CCMNR/board/rcj_res_b_board.kicad_pcb

## KiCad design rcj_res_b_board.kicad_pcb (2017-06-26)

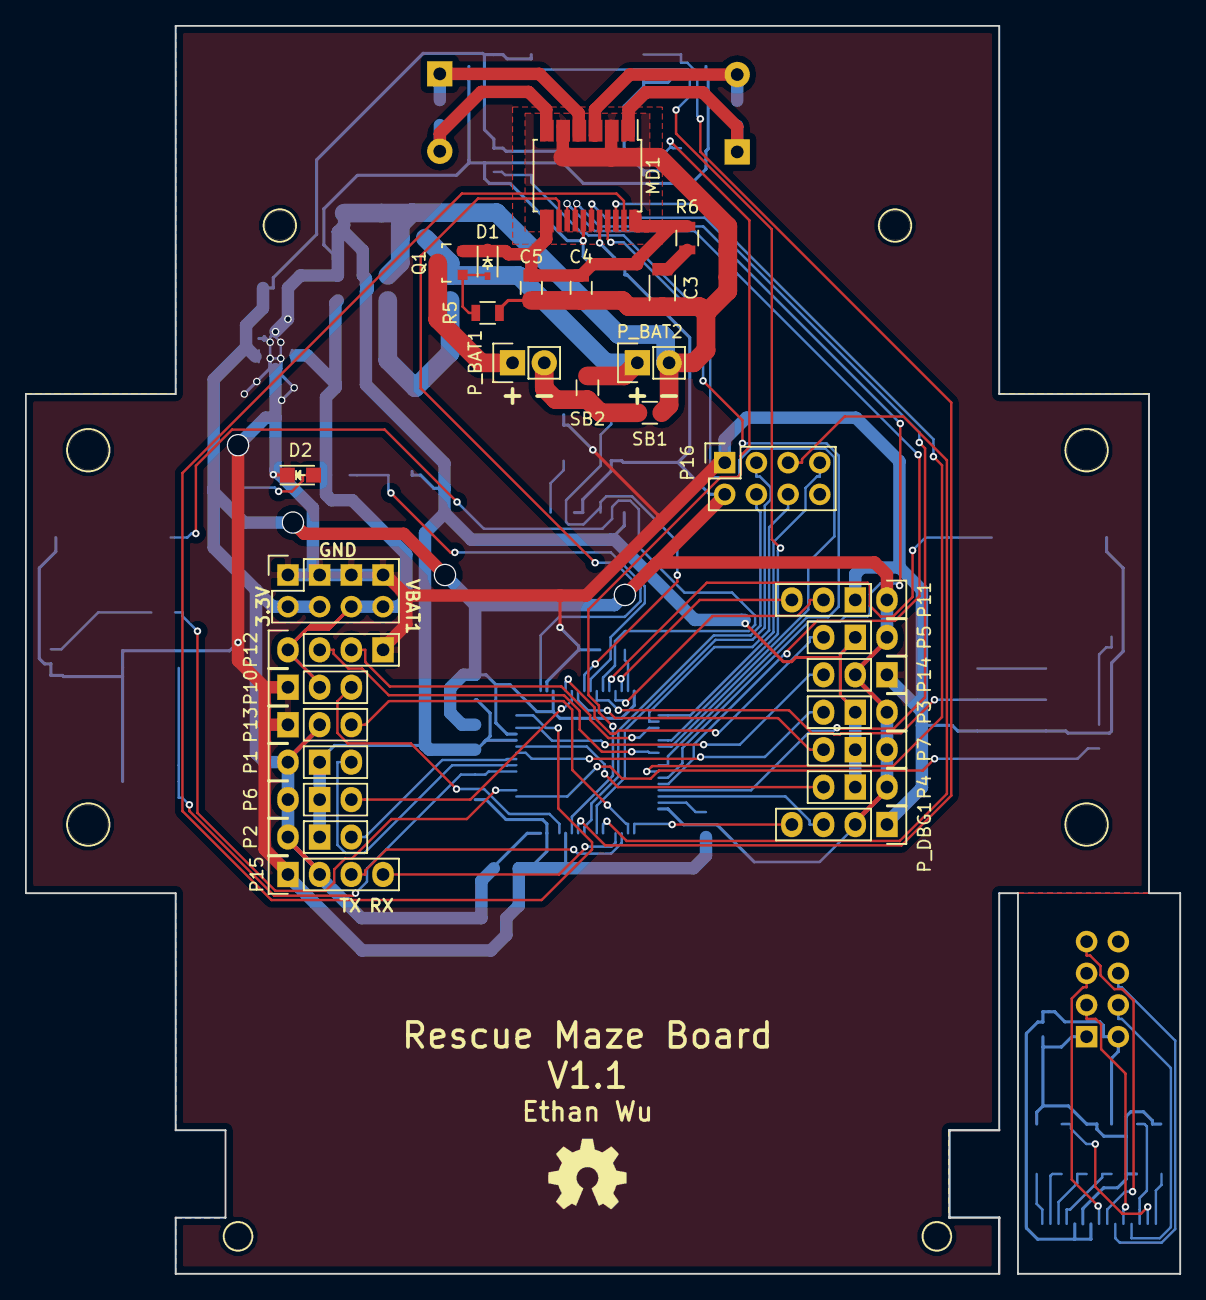
[picture p1: board rcj_res_b_board.kicad_pcb from above]

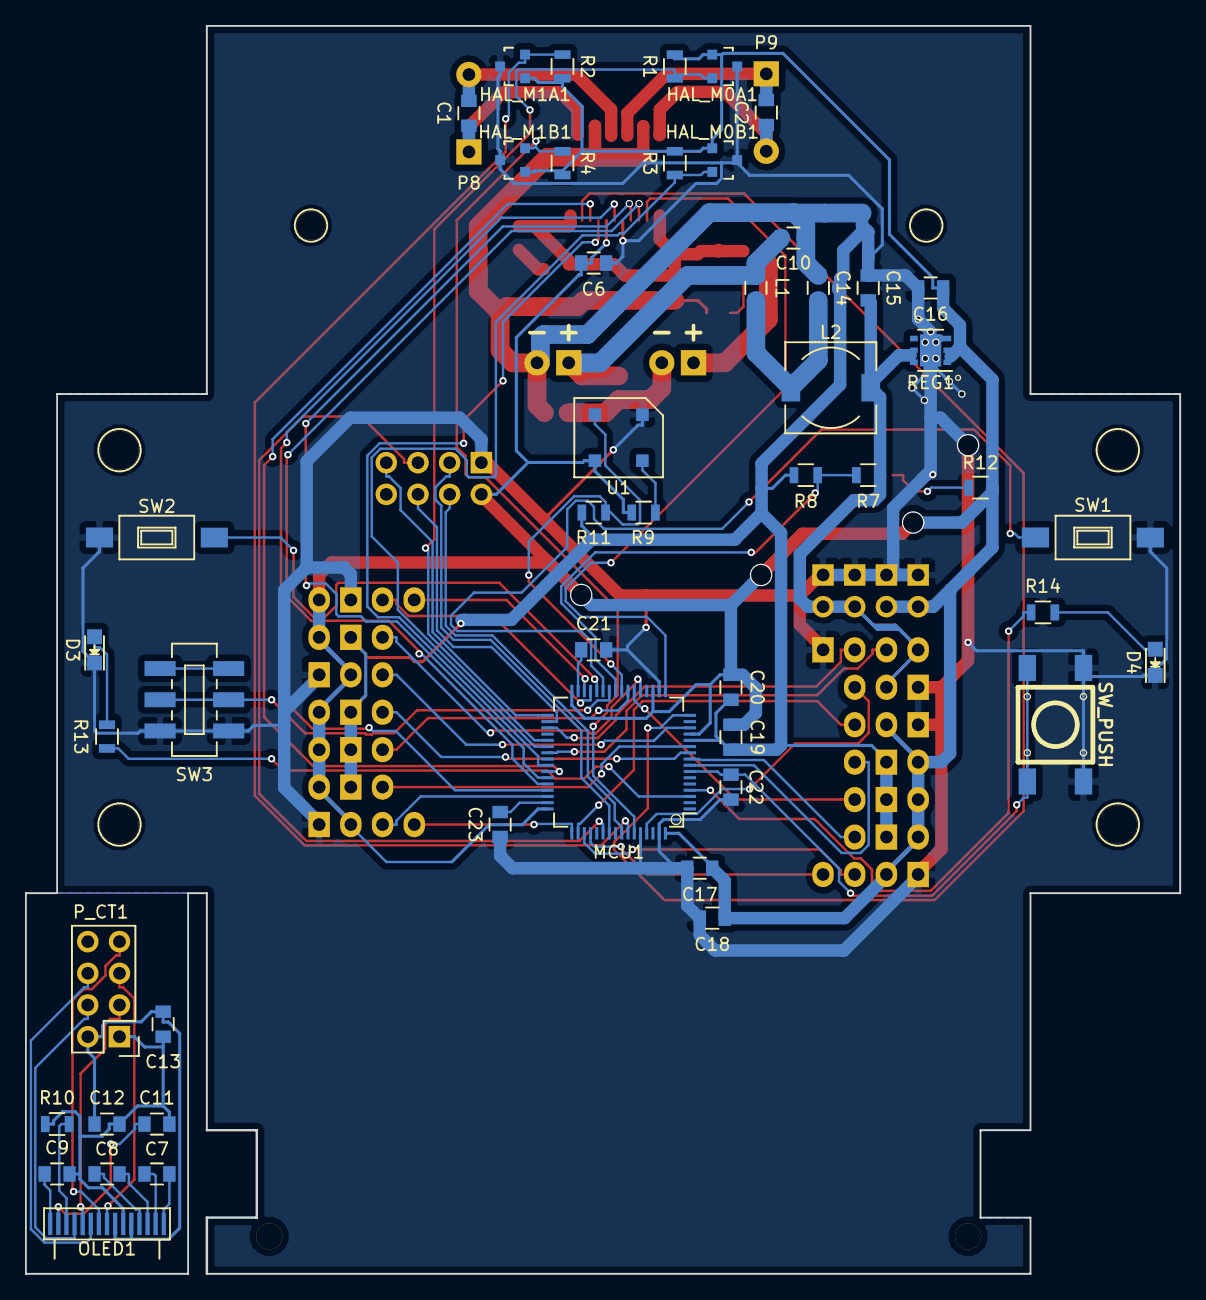
[picture p2: board rcj_res_b_board.kicad_pcb from below]

Board: 2 copper layers, 92.5 x 100.0 mm, 93 parts (54 on the bottom side), 80 nets.

Parts:
C1, C2: 3.3nF; C_0805
C3: 10uF; C_1206
C4, C6, C10, C18, C20: 0.1uF; C_0805
C5: 0.47uF; C_0805
C7, C8, C12, C13, C14: 1uF; C_0805
C9, C11, C15, C16, C17, C19, C21, C23: 10uF; C_0805
C22: 0.01uF; C_0805
D1: 6.8V; SOD-323
D2, D3, D4: LED; LED-0805
G001: LOGO; OSH_LOGO
HAL_M0A1, HAL_M0B1, HAL_M1A1, HAL_M1B1: AH1751; SOT-23
HOLE1, HOLE2, HOLE3, HOLE4, HOLE5, HOLE6, HOLE7, HOLE8: 1pin
L1: L_Small; C_0805
L2: L_Small; Choke_SMD_7.3x7.3_H3.5
MCU1: STM32F405RG; LQFP-64_10x10mm_Pitch0.5mm
MD1: TB6612FNG; SSOP-24_5.3x8.2mm_Pitch0.65mm
NT1, NT2: Net_Tie; NET_TIE_1.5mm
NT3, NT4: Net_Tie; NET_TIE_1mm
OLED1: UG-2832HSWEG04
P1, P2, P3, P4: GP2Y0A41SK0F; Socket_Strip_Straight_1x03
P5, P6, P7: GP2Y0A21YK; Socket_Strip_Straight_1x03
P8, P9: CONN_01X02; Socket_Strip_Straight_1x02
P10: SERVO0; Socket_Strip_Straight_1x03
P11: MPU9250; Socket_Strip_Straight_1x04
P12: PING0; Socket_Strip_Straight_1x04
P13, P14: CONN_01X03; Socket_Strip_Straight_1x03
P15: CONN_01X04; Socket_Strip_Straight_1x04
P16: CONN_02X04; Socket_Strip_Straight_2x04
P_BAT1, P_BAT2: CONN_01X02; Pin_Header_Straight_1x02
P_CT1: CONN_02X04; Pin_Header_Straight_2x04
P_DBG1: CONN_01X04; Socket_Strip_Straight_1x04
P_PWR1: CONN_02X04; Socket_Strip_Straight_2x04
Q1: Q_PMOS_GSD; SOT-23
R1, R2, R3, R4, R7, R8, R11: 10k; R_0805
R5: 100k; R_0805
R6: 1; R_0805
R9: 100; R_0805
R10: 390k; R_0805
R12, R13, R14: 1k; R_0805
REG1: LD39200PU; DFN-6-1EP_3x3mm_Pitch0.95mm
SB1, SB2: 0; R_0805
SW1, SW2: SW_PUSH; SW_SPST_FSMSM
SW3: SWITCH_INV; JS202011SCQN
SW_RST1: SW_PUSH; Switch_FSM_JSM
U1: OPB733TR

Connections:
/3.3V: C6.2, C16.1, C17.1, C18.1, C19.1, C20.1, HAL_M0A1.1, HAL_M0B1.1, HAL_M1A1.1, HAL_M1B1.1, MCU1.13, MCU1.19, MCU1.32, MCU1.48, MCU1.64, MD1.20, P1.1, P2.1, P3.1, P4.1, P5.1, P6.1, P7.1, P11.1, P13.2, P14.2, P15.2, P16.2, P_DBG1.2, P_PWR1.2, P_PWR1.4, R1.1, R2.1, R3.1, R4.1, R9.1, R12.1, REG1.1, REG1.2, U1.3
/I2C_SCL: MCU1.29, P11.3
/I2C_SDA: MCU1.30, P11.4
/IR_L_F: MCU1.21, P5.3
/IR_L_L: MCU1.22, P6.3
/IR_L_R: MCU1.23, P7.3
/IR_S_LB: MCU1.9, P2.3
/IR_S_LF: MCU1.8, P1.3
/IR_S_RB: MCU1.11, P4.3
/IR_S_RF: MCU1.10, P3.3
/LED_USR1: MCU1.3, R13.1
/LED_USR2: MCU1.4, R14.1
/LS_FLOOR: MCU1.24, R11.1, U1.2
/M0_ENC_A: HAL_M0A1.2, MCU1.37, R1.2
/M0_ENC_B: HAL_M0B1.2, MCU1.38, R3.2
/M1_ENC_A: HAL_M1A1.2, MCU1.58, R2.2
/M1_ENC_B: HAL_M1B1.2, MCU1.59, R4.2
/MD_AIN1: MCU1.41, MD1.21
/MD_AIN2: MCU1.42, MD1.22
/MD_APWM: MCU1.16, MD1.23
/MD_BIN1: MCU1.43, MD1.17
/MD_BIN2: MCU1.44, MD1.16
/MD_BPWM: MCU1.17, MD1.15
/MD_STBY: MCU1.45, MD1.19
/MODE_SEL: MCU1.26, SW3.2
/MOSI: MCU1.57, P16.4
/OLED_Circuitry/3.3V: C12.1, C13.1, OLED1.5, OLED1.7, P_CT1.2
/OLED_Circuitry/D-C: OLED1.10, P_CT1.6
/OLED_Circuitry/GND: C9.2, C11.2, C12.2, C13.2, OLED1.6, P_CT1.1, R10.1
/OLED_Circuitry/MOSI: OLED1.12, P_CT1.4
/OLED_Circuitry/RST: OLED1.9, P_CT1.7
/OLED_Circuitry/SCLK: OLED1.11, P_CT1.3
/OLED_Circuitry/SS: OLED1.8, P_CT1.5
/OLED_D-C: MCU1.34, P16.6
/OLED_RST: MCU1.33, P16.7
/OLED_SS: MCU1.54, P16.5
/PING0_ECHO: MCU1.35, P12.3
/PING0_TRIG: MCU1.39, P12.2
/SCLK: MCU1.55, P16.3
/SERVO0_PWM: MCU1.61, P10.3
/SWCLK: MCU1.49, P_DBG1.4
/SWDIO: MCU1.46, P_DBG1.3
/SW_USR1: MCU1.27, SW1.1
/SW_USR2: MCU1.28, SW2.1
/TEMP0_PWM: MCU1.50, P13.3
/TEMP1_PWM: MCU1.14, P14.3
/UART_RX: MCU1.52, P15.4
/UART_TX: MCU1.51, P15.3
/VBAT1: C15.1, L2.2, P10.2, P12.1, P_PWR1.6, P_PWR1.8, R7.1, REG1.5, REG1.6
/VBAT_MON: MCU1.25, R7.2, R8.1
GND: C10.2, C14.2, NT1.1, NT2.1, P_BAT2.2, SB1.1
GNDA: C19.2, C20.2, MCU1.12, NT4.2, P1.2, P2.2, P3.2, P4.2, P5.2, P6.2, P7.2, R8.2, R11.2
GNDD: C6.1, C15.2, C16.2, C17.2, C18.2, C21.2, C22.2, C23.2, D2.1, D3.1, D4.1, HAL_M0A1.3, HAL_M0B1.3, HAL_M1A1.3, HAL_M1B1.3, MCU1.18, MCU1.60, MCU1.63, MD1.18, NT3.2, P10.1, P11.2, P12.4, P13.1, P14.1, P15.1, P16.1, P_DBG1.1, P_PWR1.1, P_PWR1.3, P_PWR1.5, P_PWR1.7, REG1.3, REG1.7, SW1.2, SW2.2, SW3.1, SW_RST1.2, U1.1
GNDPWR: C3.2, C4.2, C5.2, MD1.3, MD1.4, MD1.9, MD1.10, NT1.2, R5.2
unnamed: C1.1, MD1.1, MD1.2, P8.1
unnamed: C1.2, MD1.5, MD1.6, P8.2
unnamed: C2.1, MD1.11, MD1.12, P9.2
unnamed: C2.2, MD1.7, MD1.8, P9.1
unnamed: C3.1, R6.2
unnamed: C4.1, C5.1, D1.1, MD1.13, MD1.14, MD1.24, Q1.2, R6.1
unnamed: C7.1, OLED1.1
unnamed: C7.2, OLED1.2
unnamed: C8.1, OLED1.3
unnamed: C8.2, OLED1.4
unnamed: C9.1, OLED1.15
unnamed: C10.1, L1.1, P_BAT2.1, SB2.1
unnamed: C11.1, OLED1.14
unnamed: C14.1, L1.2, L2.1
unnamed: C21.1, MCU1.31
unnamed: C22.1, MCU1.7, SW_RST1.1
unnamed: C23.1, MCU1.47
unnamed: D1.2, Q1.1, R5.1
unnamed: D2.2, R12.2
unnamed: D3.2, R13.2
unnamed: D4.2, R14.2
unnamed: NT2.2, NT3.1, NT4.1
unnamed: OLED1.13, R10.2
unnamed: P_BAT1.2, SB1.2, SB2.2
unnamed: R9.2, U1.4
VCC: P_BAT1.1, Q1.3
