CCMNR/board/(commit log)

2015-12-19 Initial commit
    Board and schematic created
    [rcj_res_b_board.kicad_pcb, rcj_res_b_board.sch]
2015-12-19 Moved SMD components to back
    Moving components to back to free up space -
    fewer physical obstacles / limitations
    [rcj_res_b_board.kicad_pcb]
2015-12-19 General updates / improvements
    Added bottom-facing IR light sensor
    Changed motor driver from Pololu boards to TB6612FNG
    Added OLED mount
    Expanded front of board to mount motors
    Added misc headers and headers for other sensors
    Motor terminals are now exposed pads and not THT pin headers
    [rcj_res_b_board.kicad_pcb, rcj_res_b_board.sch]
2015-12-26 Minor fixes
    Connected previously disconnected serial port (in schematic)
    Added labels
    Added missing cutout in side of board
    Adjusted mounting hole positions
    [rcj_res_b_board.kicad_pcb, rcj_res_b_board.sch]
2015-12-26 Moved hall-effect sensors
    Connected serial port in netlist (netlist update)
    Added pcbnew autosaves to gitignore
    [rcj_res_b_board.kicad_pcb]
2015-12-26 Prep for fabrication
    Added ground planes
    Added switches
    Added cutoffs for mounting sensors
    Added additional silkscreen info
    [PIRCutoffs.sch, rcj_res_b_board.kicad_pcb, rcj_res_b_board.sch]
2015-12-27 Power rewire
    Added reverse current protection on motor driver
    Switched most 5V devices to 3.3V
    3.3V power now comes from tapping one battery (not both)
    [PIRCutoffs.sch, rcj_res_b_board.sch]
2015-12-29 Changed power supply
    Now using one 3.3V ULDO regulator
    Removed 5V power (ping powered directly from battery)
    Added filtering network (chokes and caps)
    Added 2 indicator LEDs
    Fixed EVQPL* button footprints
    Added pcbnew lib table
    Updated .gitignore to ignore other unneccesary files (_saved*)
    [rcj_res_b_board.kicad_pcb, rcj_res_b_board.sch]
2015-12-29 Preliminary layout
    Changed push-button footprints
    [rcj_res_b_board.kicad_pcb, rcj_res_b_board.sch]
2015-12-29 Moved motor driver RCP circuit to front
    Rearranged other components to make space
    [rcj_res_b_board.kicad_pcb]
2015-12-29 Moved OLED to cut-off board
    Removed PIR cutoffs (no longer needed)
    [OLED_Circuitry.sch, rcj_res_b_board.kicad_pcb, rcj_res_b_board.sch]
2015-12-29 Initial routing
    Added solder bridges
    Added missing library
    [rcj_res_b_board.kicad_pcb, rcj_res_b_board.sch]
2015-12-30 Changed servo to use VBAT power
    Also increased size of net-ties
    [rcj_res_b_board.kicad_pcb, rcj_res_b_board.sch]
2015-12-30 More preliminary routing
    [rcj_res_b_board.kicad_pcb]
2016-01-01 Flipped cutoff around
    Changed copper fills to have no net
    [rcj_res_b_board.kicad_pcb]
2016-01-01 Moved footprints around to match physical
    Hall-effect sensors and motor connectors moved towards center
    Rotated one of the motor connectors
    Fixed overlapping silkscreens
    [rcj_res_b_board.kicad_pcb]
2016-01-01 Re-arranged headers
    Resized some screw holes
    [rcj_res_b_board.kicad_pcb]
2016-01-01 Changed drill hole size and moved decoupling cap
    Shrunk drill hole for mounting dropper (2.3mm -> 2.1mm)
    Moved motor driver decoupling cap closer to motor driver
    Fixed incorrectly placed LED
    [rcj_res_b_board.kicad_pcb]
2016-01-01 Power routing & prep for autoroute
    Moved some components to make routing power easier (net ties)
    [rcj_res_b_board.kicad_pcb]
2016-01-02 Changed grounds
    Servo now uses digital ground
    Battery monitor uses analog ground
    Moved P_PWR1's 3.3V (used for debugging) to debug header
    P_PWR2 -> P_PWR1
    [rcj_res_b_board.kicad_pcb, rcj_res_b_board.sch]
2016-01-02 Re-routed power
    Removed unnecessary wiring that wasn't power (to let autorouter route instead)
    Misc fixes
    [rcj_res_b_board.kicad_pcb]
2016-01-03 Routed
    Fixed offset / misplaced zone outline
    [rcj_res_b_board.kicad_pcb]
2016-01-03 Added thermal vias
    Final cleanup
    [rcj_res_b_board.kicad_pcb]
2016-02-01 Changed resistor value
    Changed value on phototransistor of light sensor to get higher dynamic range in readings
    (tested)
    [rcj_res_b_board.kicad_pcb, rcj_res_b_board.sch]
2016-08-19 Change resistor value
    80 ohm resistor for floor light sensor was replaced by 100 ohm on boards, update schematics to match
    [OLED_Circuitry.sch, rcj_res_b_board.kicad_pcb, rcj_res_b_board.sch]
2017-06-26 Revert PCB board KiCad version
    [rcj_res_b_board.kicad_pcb]
